pedrodechichiribeiro/robo_SCARA_desenho/modelo 3D/componentes/sensor magnetico dimensões.png

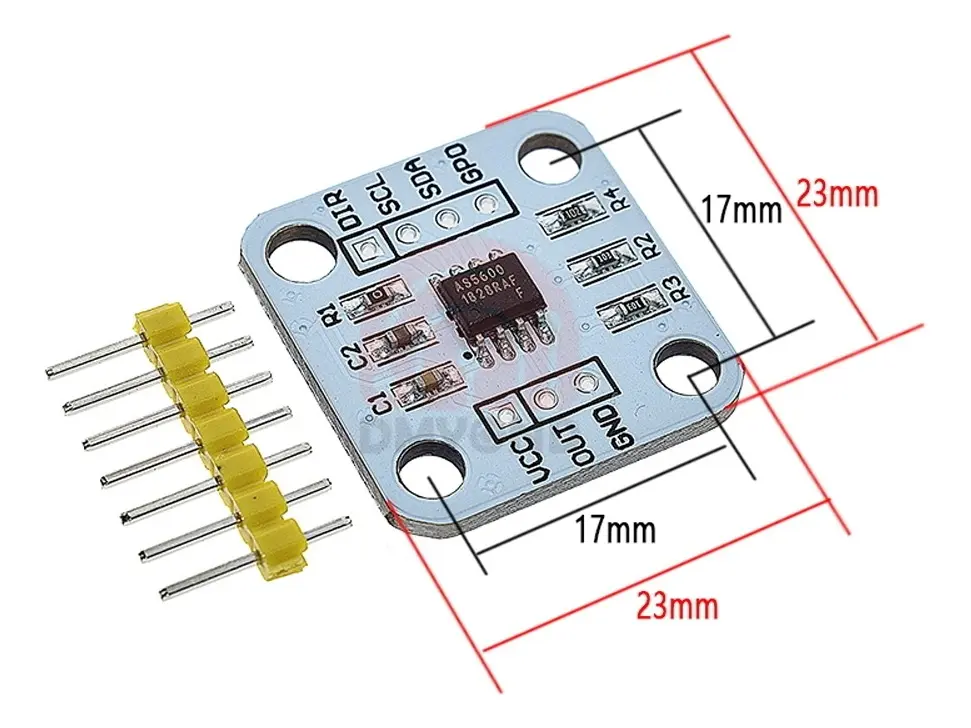
modelo 3D/componentes/sensor magnetico dimensões.png
