pedrodechichiribeiro/robo_SCARA_desenho/modelo 3D/esquemático ombro.pdf

## LEGENDA E MONTAGEM

1

Eixo metálico Ø8 mm
Comprimento inicial 120–140 mm; medir o empilhamento.

2

### 2 rolamentos 608ZZ na base

Anéis externos fixos; internos acompanham o eixo.

3

Polia comercial 60T do ombro
Fixa ao eixo. Recebe correia de 280 mm do motor 1.

4

Braço 1 e cubo de aperto
Braço rigidamente solidário ao eixo Ø8 mm.

5

Polia dupla especial 60T + 60T
Duas pistas solidárias; NÃO presa rigidamente ao eixo.

6

### 2 rolamentos 608ZZ na dupla

Externos giram com a dupla; internos apoiados no eixo.

7

Ímã diametral + AS5600
Ímã no eixo; sensor parado na base, sem contato.

8

Correia GT2 280 mm - motor 2 Alinhar o motor 2 à pista inferior da dupla.

9

Correia GT2 610 mm - cotovelo Pista superior da dupla alinhada à do cotovelo.

* O desenho ilustra eixo de 135 mm só para distribuir as peças. Espaçadores, colares e cubos terão dimensões reais no CAD.

# JUNTA 1 | OMBRO - CORTE VERTICAL

Eixo e braço 1 giram juntos; a polia dupla tem rotação independente.

CONCEITO PARA SOLIDWORKS · NÃO É DESENHO DE FABRICAÇÃO

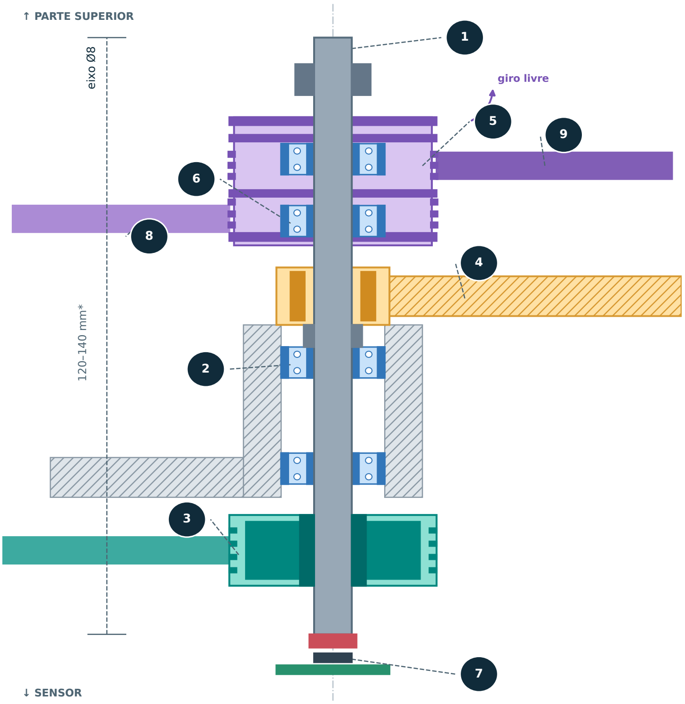
[picture p2: figure]
giro livre; eixo Ø8 120–140 mm*; ↑ PARTE SUPERIOR; ↓ SENSOR

Cores: azul = rolamento · cinza = eixo/mancal · verde-água = polia fixa · roxo = polia livre · amarelo = braço

Atenção: as pistas das três correias têm ALTURAS diferentes. Motor 2 exige suporte na altura da pista inferior da polia dupla.

## LEGENDA E MONTAGEM

1

Eixo metálico Ø8 mm
80 mm é referência; conferir cubo e retenção.

2

Rolamento 608ZZ inferior
Anel externo fixo ao mancal da ponta do braço 1.

3

Rolamento 608ZZ superior
Centro do par separado em ≈ 27–30 mm inicialmente.

4

Braço 1 + alojamento dos 608ZZ Estrutura e anéis externos não giram com o eixo.

5

Polia 60T comercial, furo Ø8
Prender rigidamente ao eixo; correia de 610 mm.

### 6 Braço 2 + cubo de fixação

Preso ao eixo; gira junto com a polia 60T.

7

Ímã diametral + AS5600
Ímã gira com o eixo; placa fixa ao braço 1.

8

Correia GT2 longa de 610 mm
A pista deve alinhar com a pista alta do ombro.

* É possível que 90 mm sejam necessários para a retenção. Não comprar/cortar eixo até medir cubo e largura da polia.

# JUNTA 2 | COTOVELO - CORTE VERTICAL

A polia 60T, o eixo e o braço 2 giram juntos; o mancal e o AS5600 acompanham o braço 1.

CONCEITO PARA SOLIDWORKS · NÃO É DESENHO DE FABRICAÇÃO

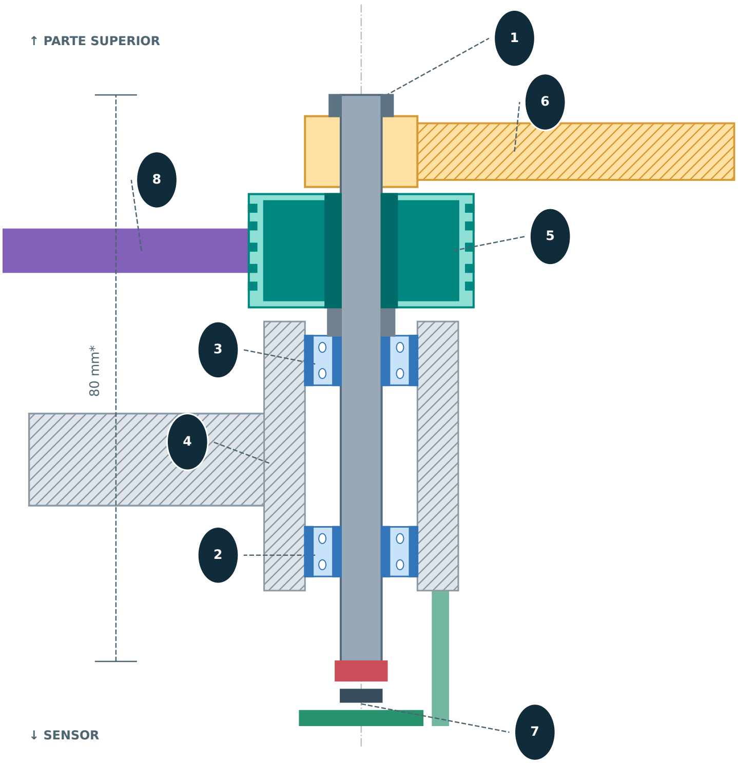
[picture p3: figure]
↑ PARTE SUPERIOR; ↓ SENSOR

Cores: azul = rolamento · cinza = eixo/mancal · verde-água = polia fixa · amarelo = braço

AS5600 fica embaixo, mas NÃO apoia o eixo. A distância ímã-chip deve ser regulável e conferida com a leitura do sensor.
