pedrodechichiribeiro/robo_SCARA_desenho/modelo 3D/componentes/motor dimensoes.jpg

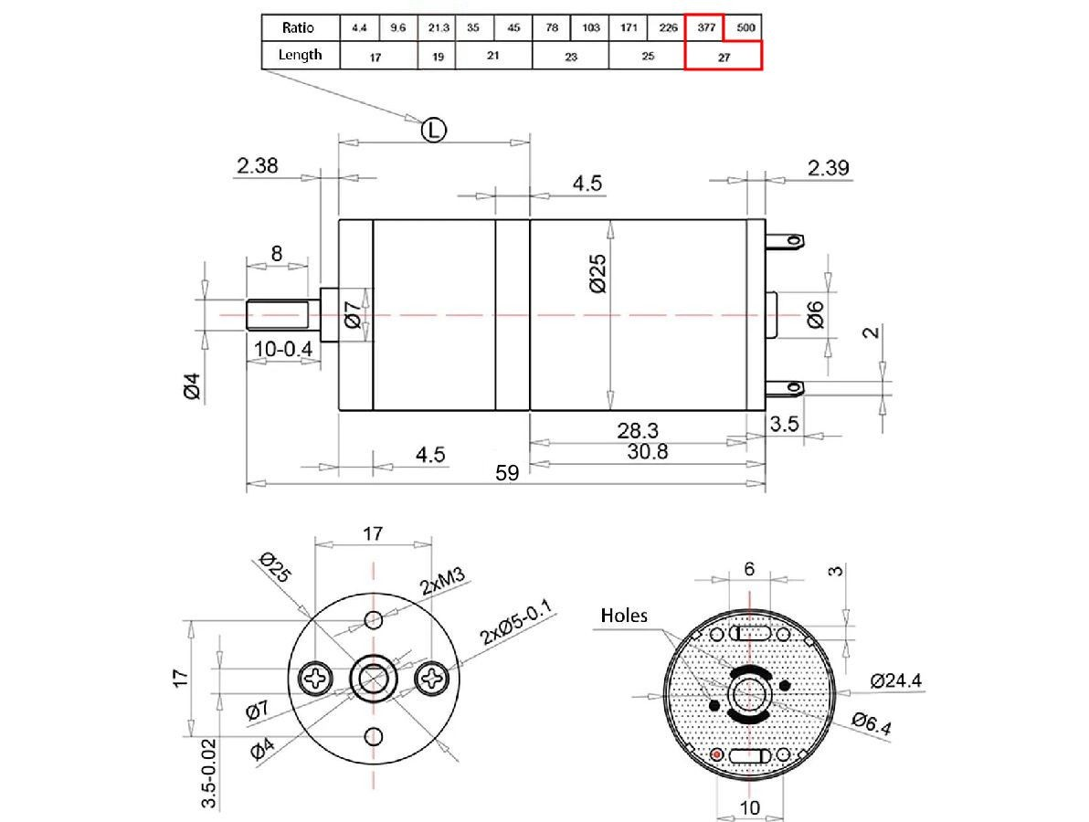
modelo 3D/componentes/motor dimensoes.jpg
