pedrodechichiribeiro/robo_SCARA_desenho/modelo 3D 2/Base Finalizada.step.SLDPRT

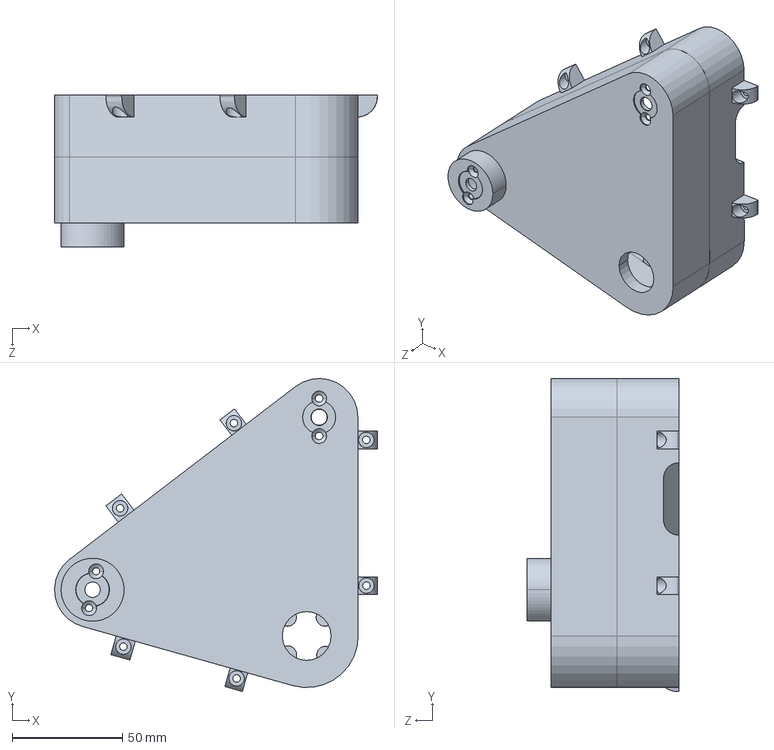
[picture p13: CAD file, 2026-11-06]
modelo 3D 2/Base Finalizada.step.SLDPRT
146.3 x 141.7 x 68.9 mm
