pedrodechichiribeiro/robo_SCARA_desenho/modelo 3D/Base Finalizada.step.SLDPRT

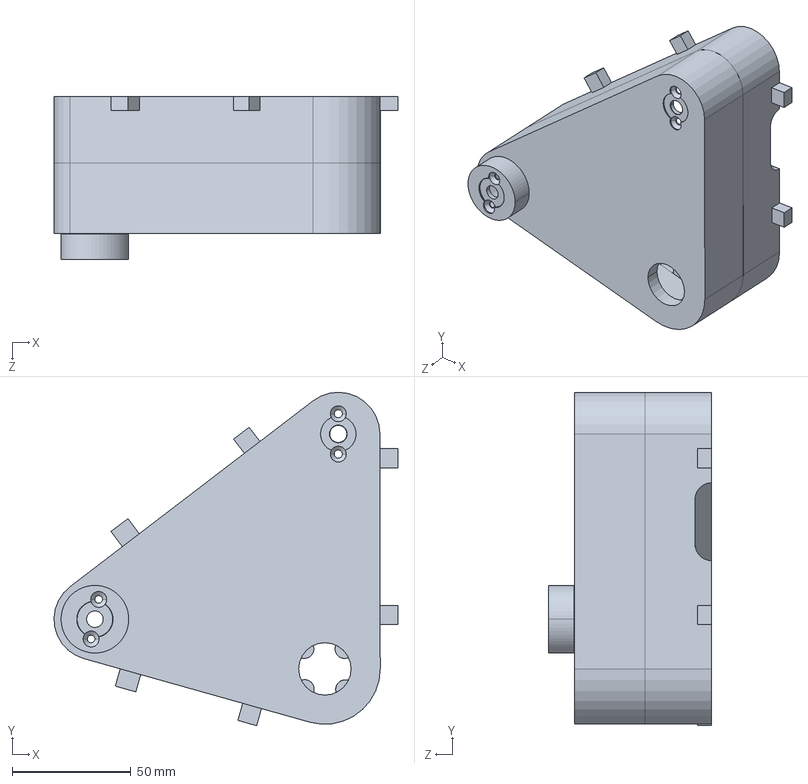
[picture p14: CAD file, 2026-11-06]
modelo 3D/Base Finalizada.step.SLDPRT
145.0 x 140.5 x 68.9 mm
