pedrodechichiribeiro/robo_SCARA_desenho/modelo 3D/componentes/gt2-60t-8.step.SLDPRT

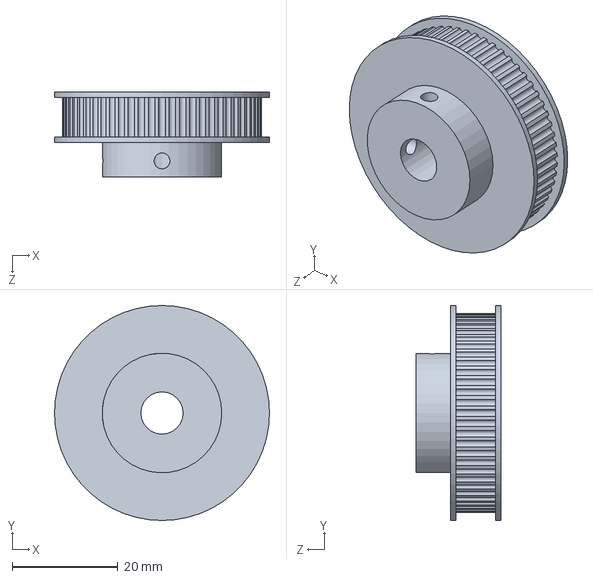
[picture p15: CAD file, 2026-11-05]
modelo 3D/componentes/gt2-60t-8.step.SLDPRT
40.7 x 40.7 x 16.0 mm
