pedrodechichiribeiro/robo_SCARA_desenho/modelo_no_MATLAB/link3_Valor predeterminado_sldprt.STEP

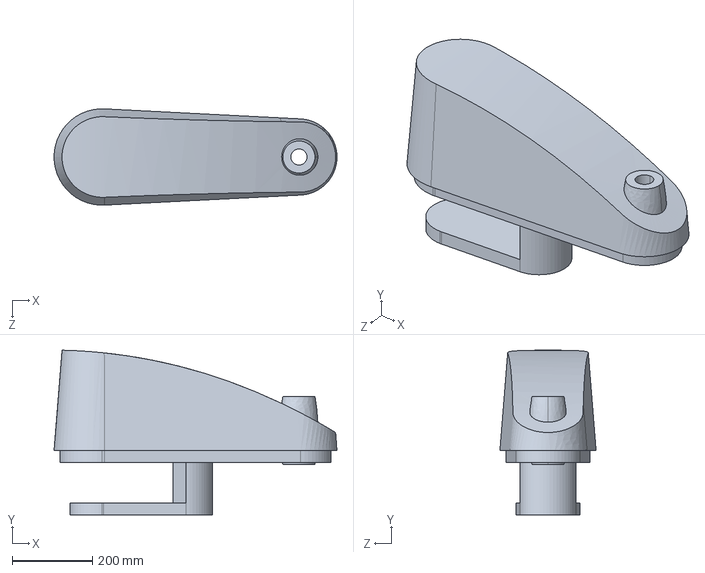
[picture p16: CAD file, 2026-09-24]
modelo_no_MATLAB/link3_Valor predeterminado_sldprt.STEP
704.8 x 410.0 x 239.7 mm
