pedrodechichiribeiro/robo_SCARA_desenho/modelo 3D finalizado/Braço.STEP

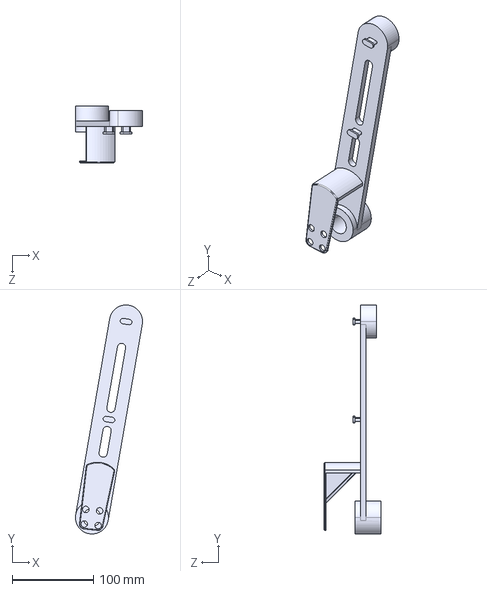
[picture p17: CAD file, 2026-11-06]
modelo 3D finalizado/Braço.STEP
82.7 x 282.1 x 69.7 mm
