pedrodechichiribeiro/robo_SCARA_desenho/modelo 3D/componentes/gt2 60 adaptado ombro.SLDPRT

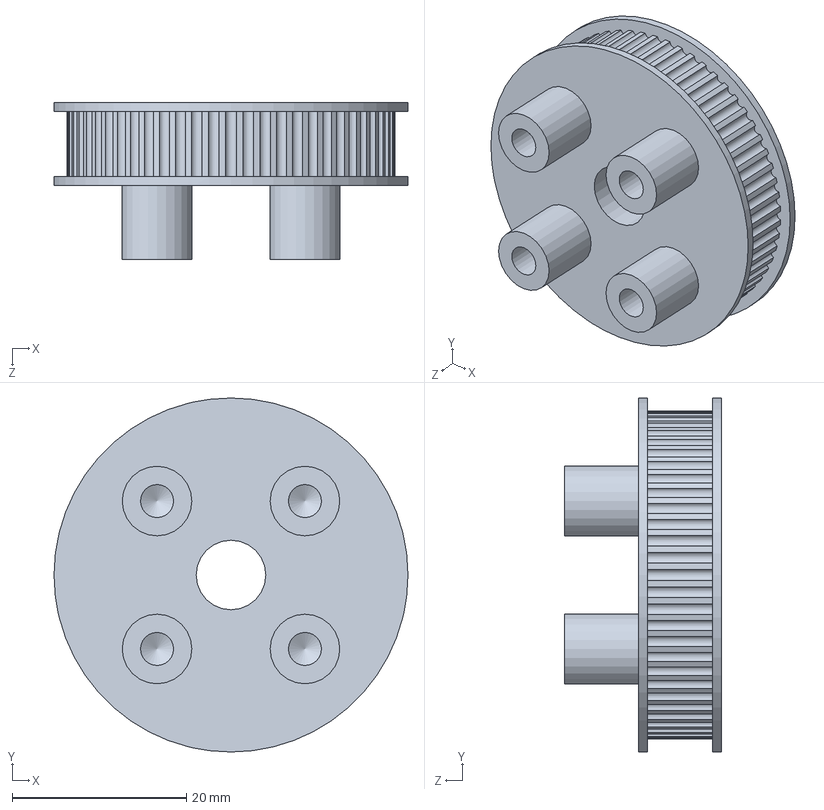
[picture p18: CAD file, 2026-11-05]
modelo 3D/componentes/gt2 60 adaptado ombro.SLDPRT
40.7 x 40.7 x 18.0 mm
