pedrodechichiribeiro/robo_SCARA_desenho/modelo_no_MATLAB/link2_Valor predeterminado_sldprt.STEP

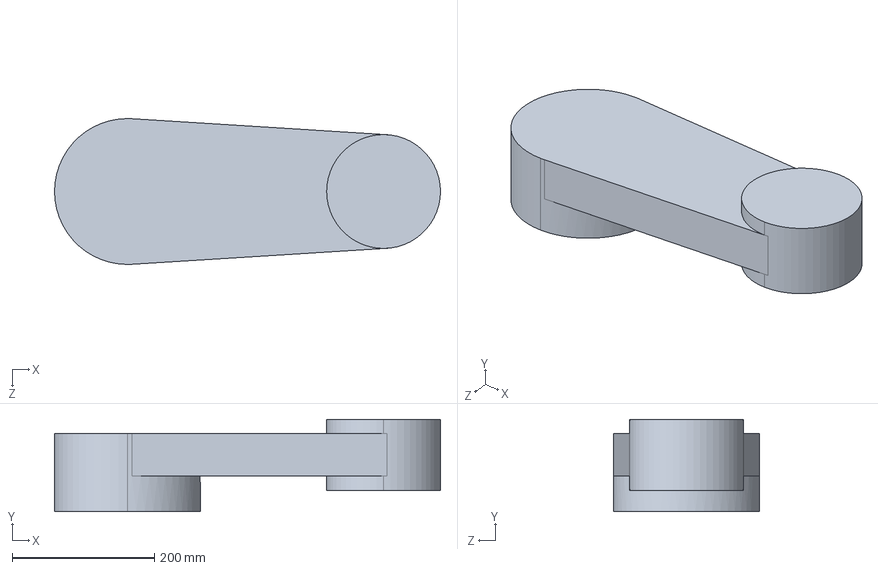
[picture p19: CAD file, 2026-09-24]
modelo_no_MATLAB/link2_Valor predeterminado_sldprt.STEP
542.5 x 130.0 x 205.0 mm
