pedrodechichiribeiro/robo_SCARA_desenho/modelo 3D finalizado/Antebraço provisorio 2.STEP

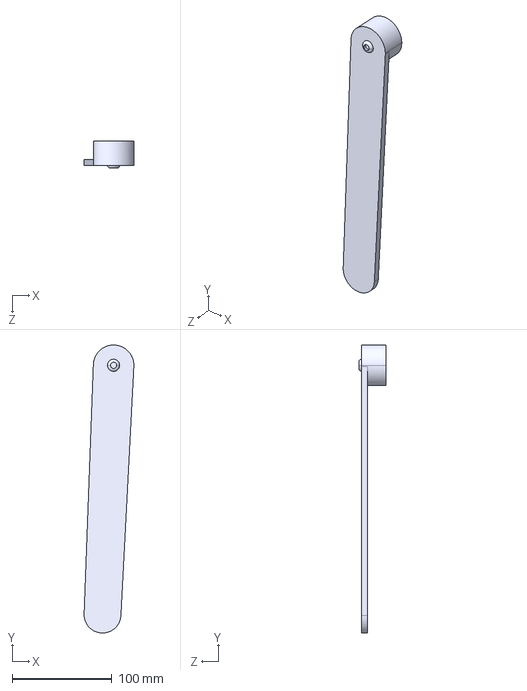
[picture p20: CAD file, 2026-11-06]
modelo 3D finalizado/Antebraço provisorio 2.STEP
49.9 x 288.8 x 27.5 mm
