pedrodechichiribeiro/robo_SCARA_desenho/modelo 3D/Base Finalizada.STEP

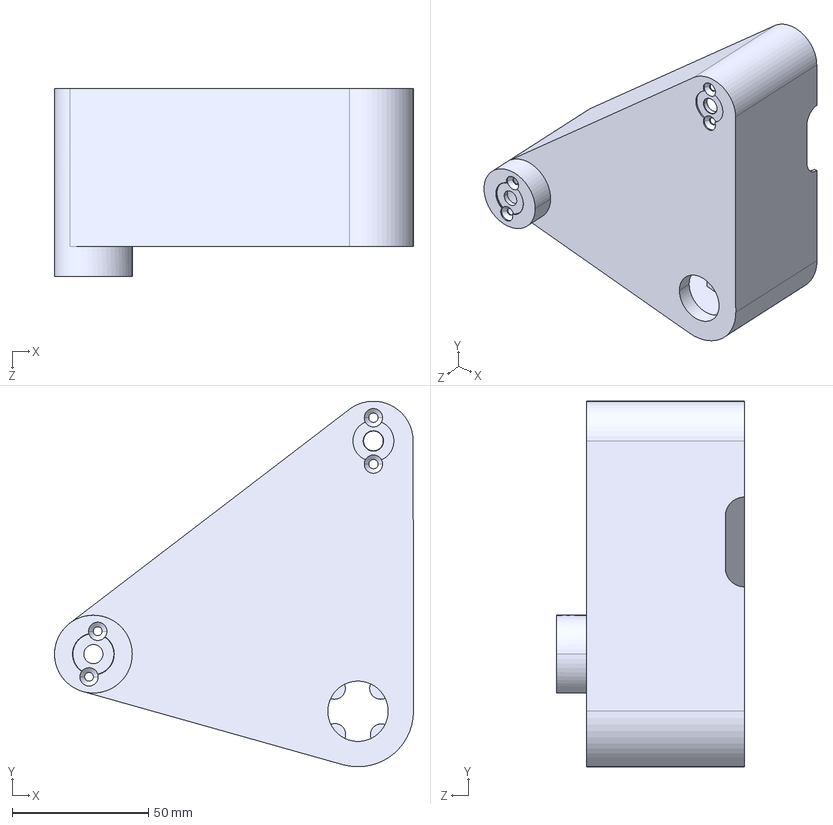
[picture p21: CAD file, 2026-11-05]
modelo 3D/Base Finalizada.STEP
131.5 x 133.9 x 68.9 mm
