pedrodechichiribeiro/robo_SCARA_desenho/modelo 3D/componentes/Eixo Ombro.step.SLDPRT

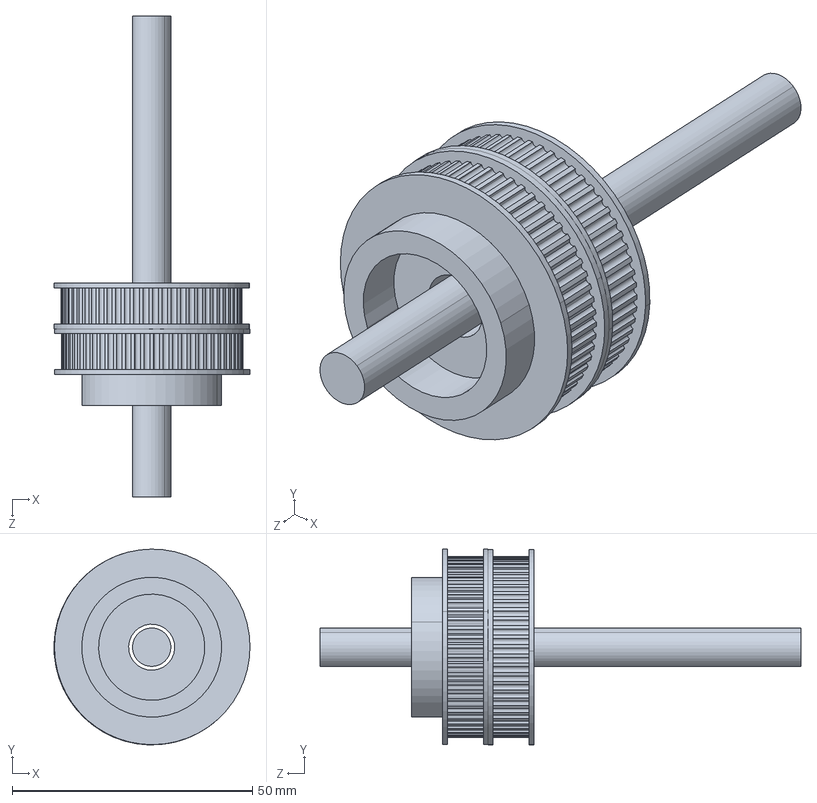
[picture p22: CAD file, 2026-11-05]
modelo 3D/componentes/Eixo Ombro.step.SLDPRT
40.8 x 40.7 x 100.0 mm
