pedrodechichiribeiro/robo_SCARA_desenho/modelo_no_MATLAB/link4_Valor predeterminado_sldprt.STEP

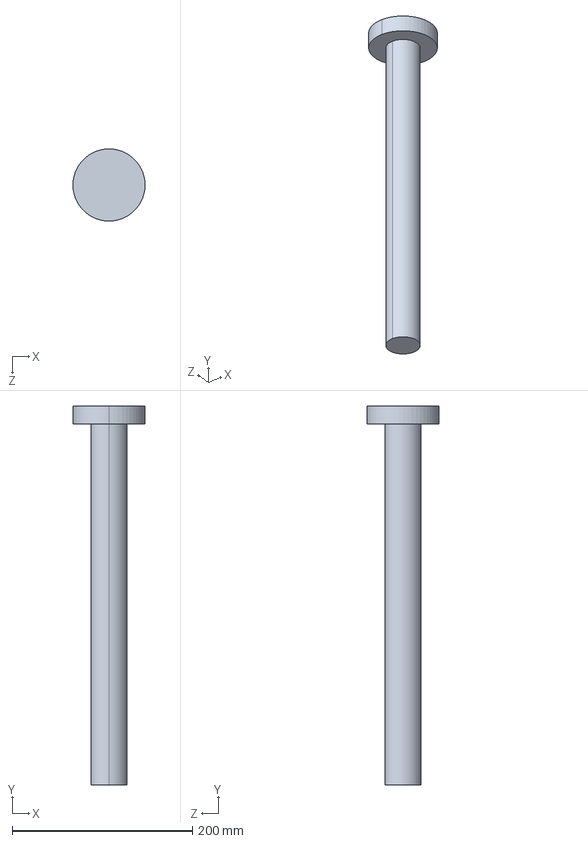
[picture p23: CAD file, 2026-09-24]
modelo_no_MATLAB/link4_Valor predeterminado_sldprt.STEP
80.0 x 420.0 x 80.0 mm
