pedrodechichiribeiro/robo_SCARA_desenho/modelo 3D 2/Base Final.STEP

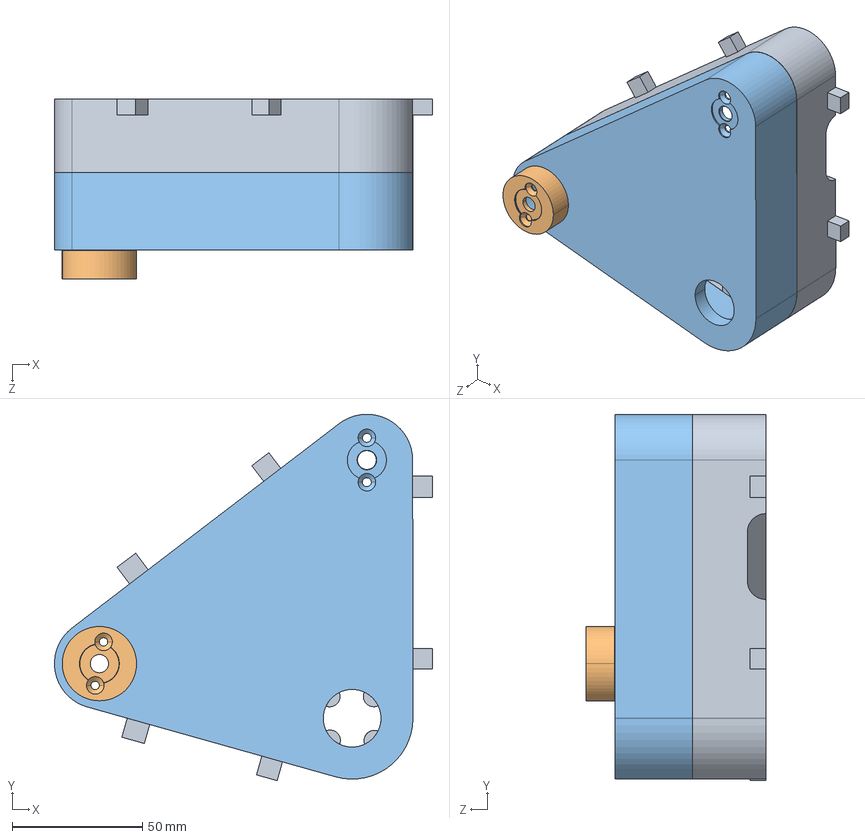
[picture p24: CAD file, 2026-11-06]
modelo 3D 2/Base Final.STEP
145.0 x 140.5 x 68.9 mm
