pedrodechichiribeiro/robo_SCARA_desenho/modelo 3D/componentes/motor.SLDPRT

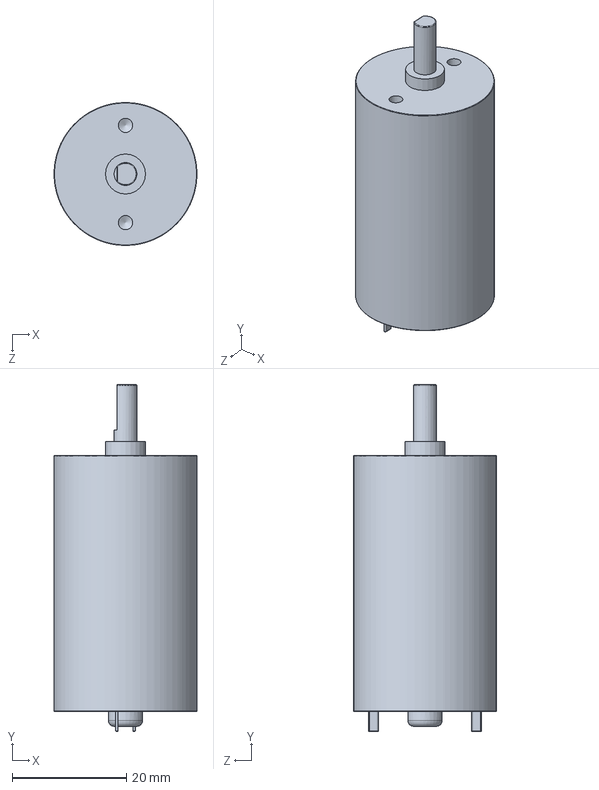
[picture p25: CAD file, 2026-11-05]
modelo 3D/componentes/motor.SLDPRT
25.0 x 60.7 x 25.0 mm
