pedrodechichiribeiro/robo_SCARA_desenho/modelo_no_MATLAB/link1_Valor predeterminado_sldprt.STEP

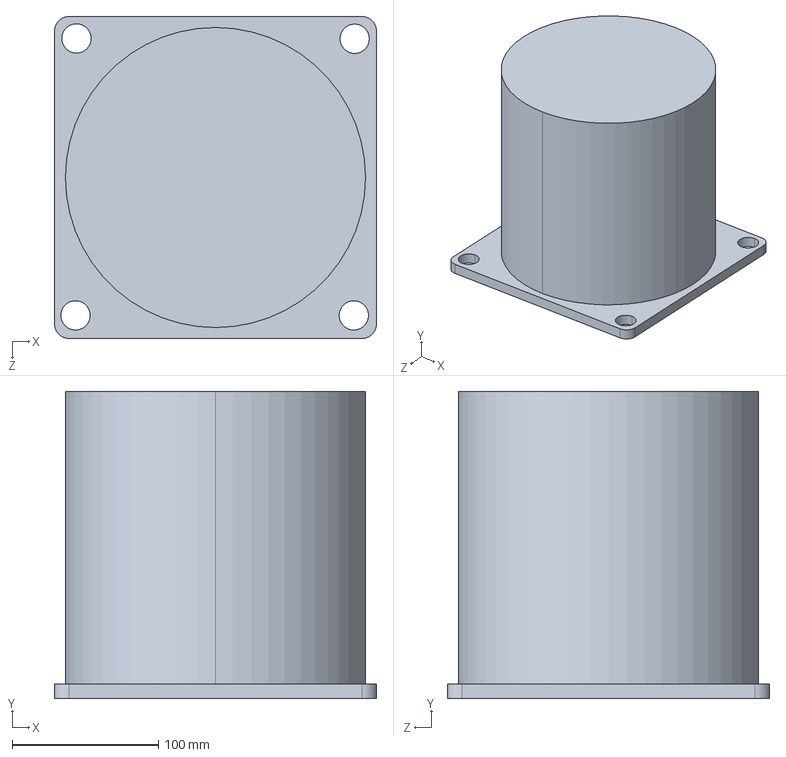
[picture p26: CAD file, 2026-09-24]
modelo_no_MATLAB/link1_Valor predeterminado_sldprt.STEP
220.0 x 210.0 x 220.0 mm
