pedrodechichiribeiro/robo_SCARA_desenho/modelo 3D 2/Base Finalizada.STEP

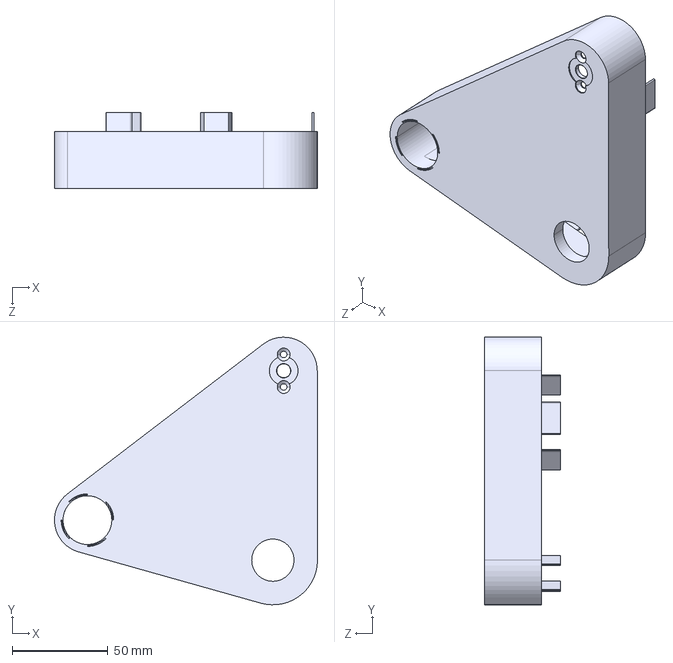
[picture p28: CAD file, 2026-11-06]
modelo 3D 2/Base Finalizada.STEP
137.5 x 139.9 x 39.5 mm
