pedrodechichiribeiro/robo_SCARA_desenho/modelo 3D/Braço.STEP

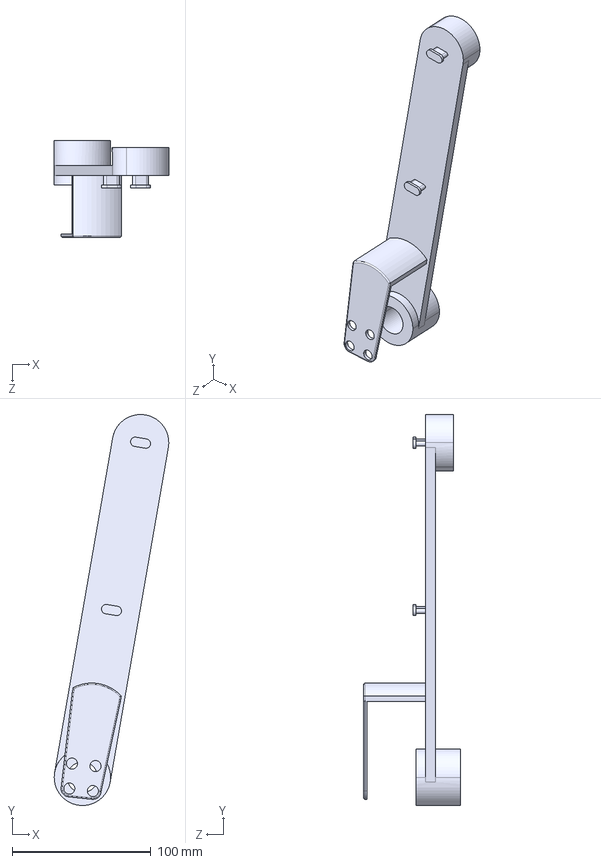
[picture p29: CAD file, 2026-11-05]
modelo 3D/Braço.STEP
82.7 x 282.1 x 69.7 mm
