pedrodechichiribeiro/robo_SCARA_desenho/modelo 3D/componentes/gt2-20t-8.step

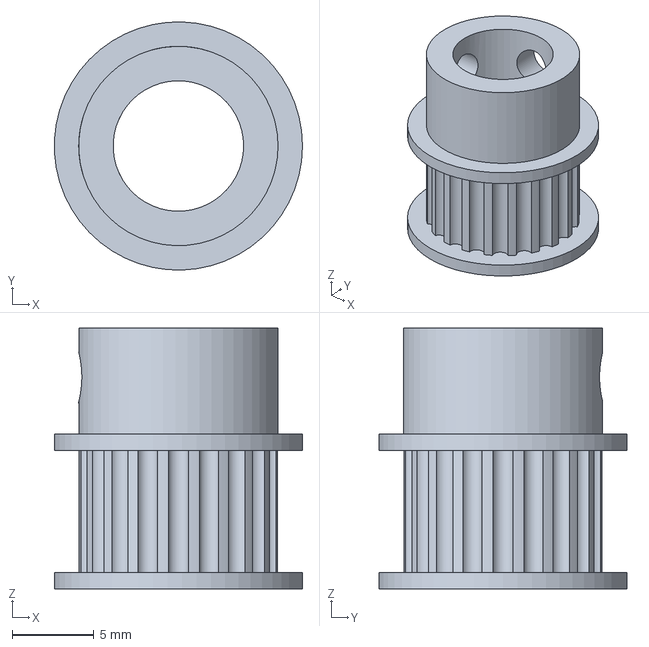
[picture p30: CAD file, 2026-11-04]
modelo 3D/componentes/gt2-20t-8.step
15.2 x 15.2 x 16.0 mm
