pedrodechichiribeiro/robo_SCARA_desenho/modelo 3D/componentes/gt2-20t-8 com acoplamento.STEP

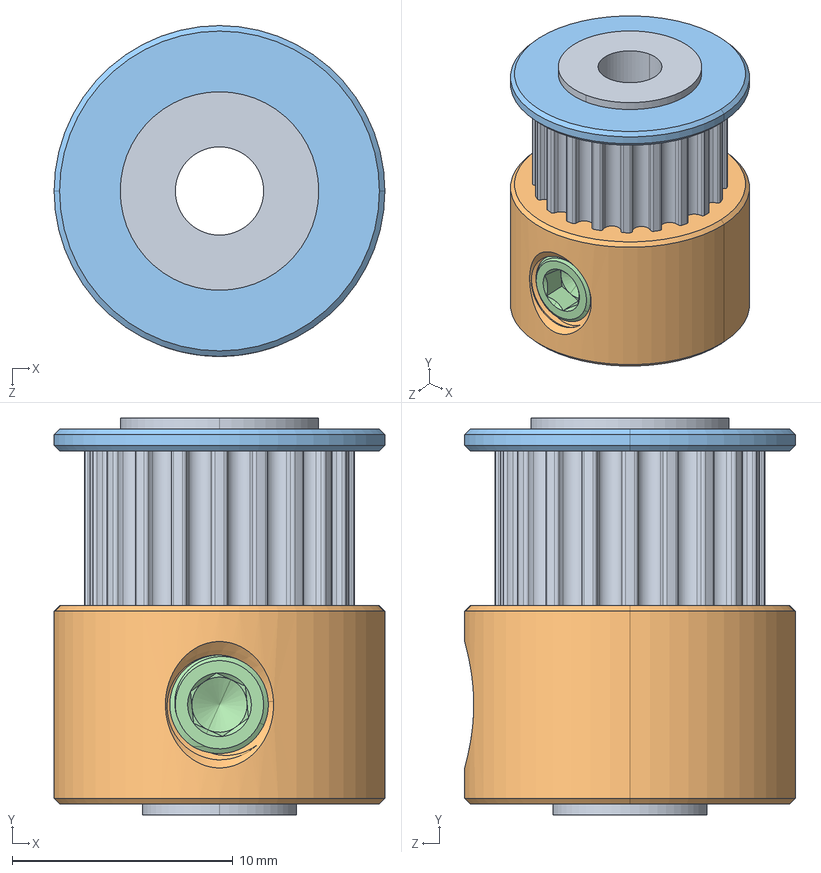
[picture p31: CAD file, 2026-11-04]
modelo 3D/componentes/gt2-20t-8 com acoplamento.STEP
15.0 x 18.0 x 15.0 mm
3422-0004-0020 core
3422 series barrel
3422 series flange
2806-0005-0005_91390A117
