pedrodechichiribeiro/robo_SCARA_desenho/modelo 3D/componentes/Eixo 8mm 12cm.STEP

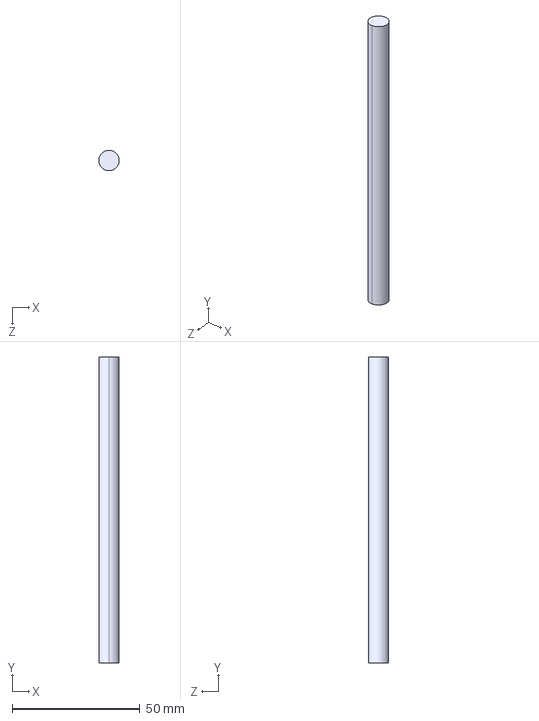
[picture p32: CAD file, 2026-11-04]
modelo 3D/componentes/Eixo 8mm 12cm.STEP
8.00 x 120.0 x 8.00 mm
