pedrodechichiribeiro/robo_SCARA_desenho/modelo 3D/componentes/Eixo 8mm.STEP

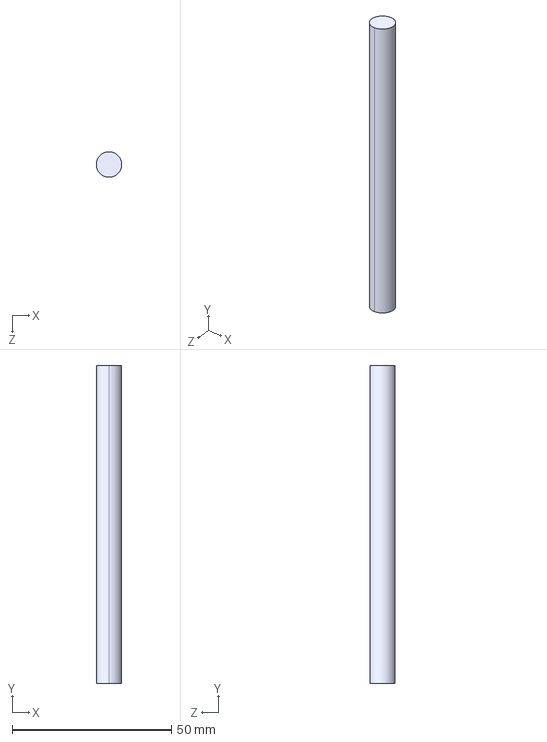
[picture p33: CAD file, 2026-11-04]
modelo 3D/componentes/Eixo 8mm.STEP
8.00 x 100.0 x 8.00 mm
