pedrodechichiribeiro/robo_SCARA_desenho/modelo 3D/componentes/Servo-sg90.step

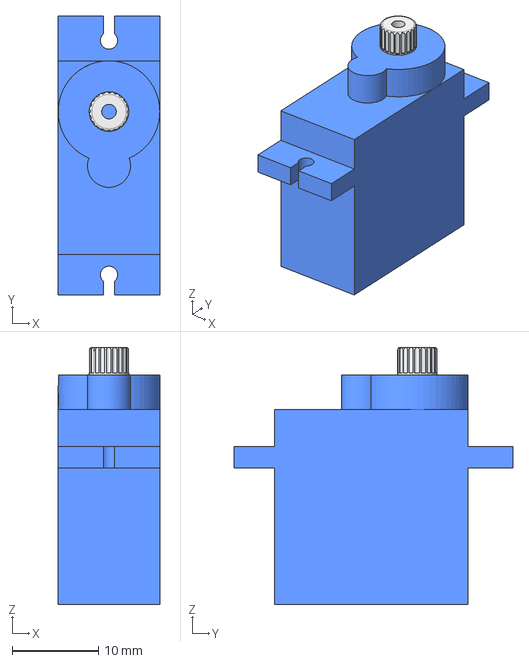
[picture p34: CAD file, 2026-11-04]
modelo 3D/componentes/Servo-sg90.step
11.8 x 32.4 x 29.9 mm
