pedrodechichiribeiro/robo_SCARA_desenho/modelo 3D/componentes/608zz.stp

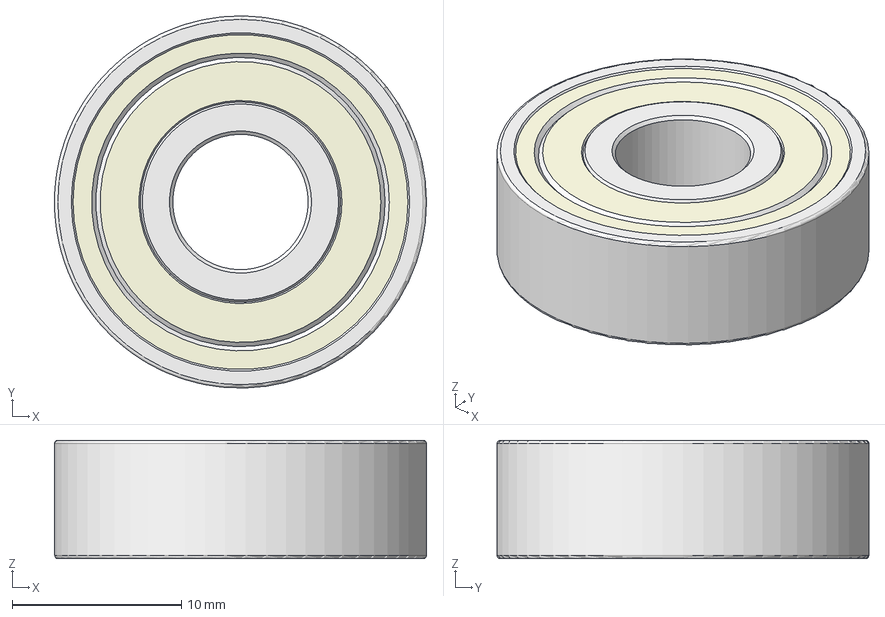
[picture p35: CAD file, 2026-11-04]
modelo 3D/componentes/608zz.stp
22.0 x 22.0 x 7.00 mm
