pedrodechichiribeiro/robo_SCARA_desenho/modelo 3D/Mont1.SLDASM

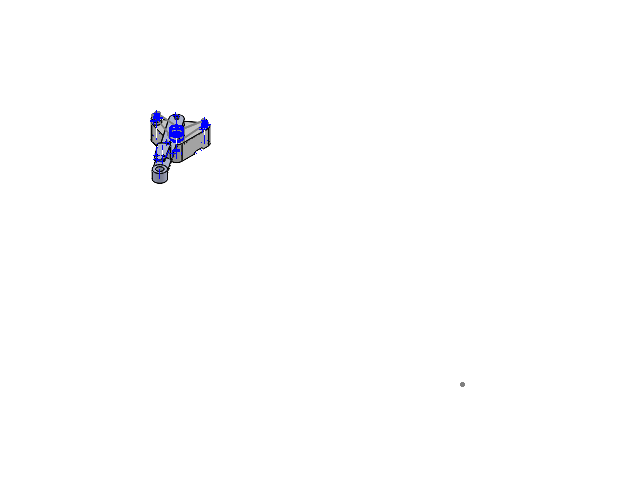
[picture p36: CAD file, 2026-11-05]
modelo 3D/Mont1.SLDASM
motor x 2
3422-0004-0020 core x 2
3422 series barrel x 2
3422 series flange x 2
2806-0005-0005_91390A117 x 2
Peça10
gt2-60t-8
608zz.stp x 2
Eixo 8mm.step
Peça2_Eixo de transferencia ombro-cotovelo
Braço.step
Correia1-1^Mont1
Correia2-2^Mont1
