pedrodechichiribeiro/robo_SCARA_desenho/(list of files, cad)

Other CAD files:
modelo 3D/gt2-20t-8 com acoplamento.SLDASM
modelo 3D/componentes/Eixo de transferencia ombro-cotovelo.SLDASM
modelo 3D/Eixo de transferencia ombro-cotovelo.SLDASM
modelo 3D finalizado/Base Final 2.STEP
modelo 3D 2/Base Final 2.STEP
modelo 3D 2/base finalizada 2.SLDPRT
modelo 3D finalizado/Braço.step.SLDPRT
modelo 3D/Peça2_Eixo de transferencia ombro-cotovelo.SLDPRT
modelo 3D 2/Braço.step.SLDPRT
modelo 3D/componentes/Eixo Ombro.STEP
modelo 3D/componentes/gt2-60t-10 adaptado.SLDPRT
modelo 3D/3422 series flange.SLDPRT
modelo 3D/componentes/gt2-60t-8.STEP
modelo 3D/gt2-60t-8.SLDPRT
modelo 3D/3422 series barrel.SLDPRT
modelo 3D/2806-0005-0005_91390A117.SLDPRT
modelo 3D/3422-0004-0020 core.SLDPRT
modelo 3D/componentes/gt2-60t-10.STEP
modelo 3D 2/Base Finalizada.SLDPRT
modelo 3D finalizado/Antebraço provisorio 2.SLDPRT
modelo 3D/Base Finalizada.SLDPRT
modelo 3D/Braço.SLDASM
modelo 3D/Braço.SLDPRT
modelo 3D/componentes/gt2-60t-10.SLDPRT
