pedrodechichiribeiro/robo_SCARA_desenho/(commit log)

2026-09-24 modelo no matlab
    levemente desatualizado
    [ScaraRobot.xml, link1_Valor predeterminado_sldprt.STEP, link2_Valor predeterminado_sldprt.STEP, link3_Valor predeterminado_sldprt.STEP, link4_Valor predeterminado_sldprt.STEP, link5_Valor predeterminado_sldprt.STEP]
2026-11-04 atualização da build
    [2806-0005-0005_91390A117.SLDPRT, 3422 series barrel.SLDPRT, 3422 series flange.SLDPRT, 3422-0004-0020 core.SLDPRT, 608zz.stp, Base Motor 1.SLDPRT, Eixo 8mm 12cm.STEP, Eixo 8mm.STEP]
2026-11-04 atualização
    [Mont1.SLDASM]
2026-11-05 atualizacao pós braço
    [Antebraço.SLDPRT, Antebraço.STEP, Base Finalizada.SLDPRT, Base Finalizada.STEP, Base Motor 1.SLDPRT, Braço.SLDASM, Braço.SLDPRT, Braço.STEP]
2026-11-06 commit pré-caneta
    [Antebraço provisorio 2.SLDPRT, Antebraço provisorio 2.STEP, Antebraço.STEP, Base Final 2.STEP, Base Final.STEP, Base Finalizada.SLDPRT, Base Finalizada.STEP, Base Finalizada.step.SLDPRT]
